OmarAbundis/Habbetat-Colmena-saludable/Control_Sensores_Temp_Hum_CO2_Interior/Base_de_datos_My_SQL_interior_colmena/README.md

# Creación de la base de datos MySQL para los datos del interior de la colmena

# Resumen

La base de datos se creó en una máquina virtual de Ubuntu 20.04 usando MySQL. Los datos obtenidos de los sensores MQ135 y DHT11 son enviados por MQTT en formato json al broker local donde son leìdos por el flow de NodeRed y guardados en nuestra base de datos local usando el nodo MySQL. Posteriormente está base de datos es usada com fuente de datos para un panel de Grafana donde visualizamos el comportamiento local.

# Software a utilizar
* Maquina virtual con Ubuntu 20.04
* My Sql para Linux [Paquete descargable](https://dev.mysql.com/downloads/mysql/)

# Instrucciones para creación de base de datos

1. Abrir una terminal e instalar mysql server con los comandos
* `sudo apt update`
* `sudo apt install mysql-server`
    
2. Ejecutar mysql
* `sudo mysql`
    
3. Crear una nueva base de datos para guardar los datos de los sensores
* `CREATE DATABASE sensor_MQ_DHT;`
    
4. Seleccionar base de datos
* `use sensor_MQ_DHT;`
    
5. Crear una tabla llamada Datos_Sensores que contenga todos los campos necesarios
* `CREATE TABLE Datos_Sensores (n_registro INT(7) UNSIGNED AUTO_INCREMENT PRIMARY KEY, fecha TIMESTAMP DEFAULT CURRENT_TIMESTAMP, id_sensor CHAR (248) NOT NULL, ValorAnalogico FLOAT(7,3) NOT NULL, VoltajeAnalogico FLOAT(7,3) NOT NULL, Temperatura FLOAT(7,3) NOT NULL, Humedad FLOAT(7,3) NOT NULL);`
    
Esto creará la base de datos que guardará nuestros datos que son
* id_sensor
* ValorAnalogico
* VoltajeAnalogico
* Temperatura
* Humedad

6. Se requiere crear un usuario y contraseña para poder ingresar posteriormente desde Grafana a nuestra base de datos, lo creamos usando las instrucciones

* `CREATE USER 'raymundo_soto'@'localhost' IDENTIFIED BY 'contrasena';`
* `GRANT ALL PRIVILEGES ON *.* TO 'raymundo_soto'@'localhost';`

Esto nos permitirá el acceso  a nuestra base de datos local.

7. Para guardar desde Node se usan los siguientes Nodos mqtt, función y MySQL
<p align="center">
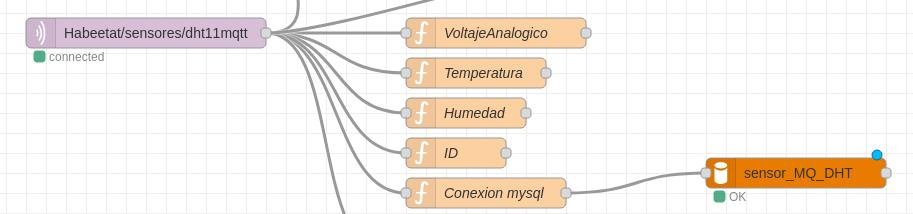
[picture p63: Control_Sensores_Temp_Hum_CO2_Interior/imagenes_interior/raymundo_flow_base_datos_23.jpg]

</p>
* El nodo mqtt se conecta al tópico `Habettat/sensores/dht11mqtt` del broker local donde publica el ESP32
* El nodo función *Conexión mysql* se programa para que publique los datos en la base de datos creada anteriormente, el código del nodo es:

~~~~
msg.topic = "INSERT INTO Datos_Sensores (id_sensor, ValorAnalogico, VoltajeAnalogico, Temperatura, Humedad) VALUES ('" + msg.payload.id + "',
" + msg.payload.ValorAnalogico + "," + msg.payload.VoltajeAnalogico + "," + msg.payload.Temperatura + "," + msg.payload.Humedad +");"
return msg;
~~~~
Este nodo estará enviando los datos a la tabla Datos_Sensores para guardarlos en la base de datos. 

* El nodo mysql ´sensor_MQ_DHT´ se configura para conectarse la base creada en el punto 3; la database debe ser _sensor_MQ_DHT_, el Host localhost, en el puerto 3306 y el usuario y contraseña del punto 6.

<p align="center">

</p>

Una vez creada la base de datos podemos usarla para visualizar datos en Grafana o tomarlos para hacer predicciones de comportamiento.
  
# Resultados

La base de datos con la tabla creada se muestra a continuación

<p align="center">
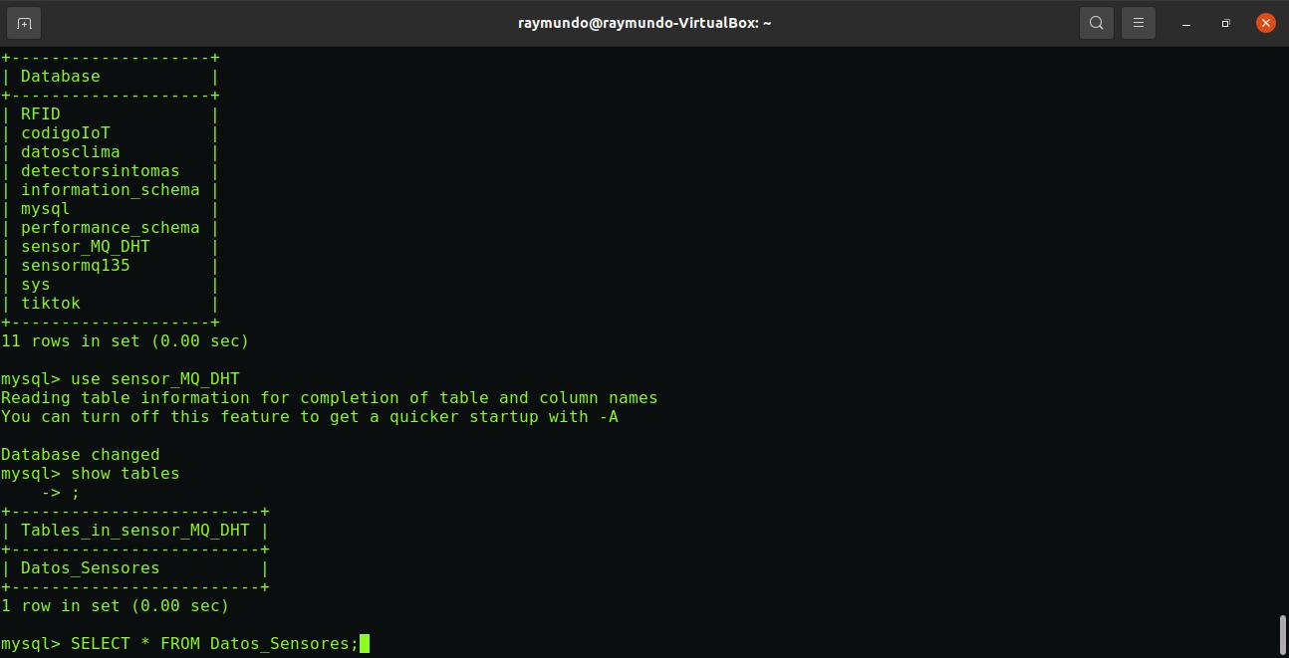
[picture p64: Control_Sensores_Temp_Hum_CO2_Interior/imagenes_interior/raymundo_21_tablas_BD_21.jpg]

</p>

Los datos guardados desde el flow de nodered se muestra en esta imagen
<p align="center">
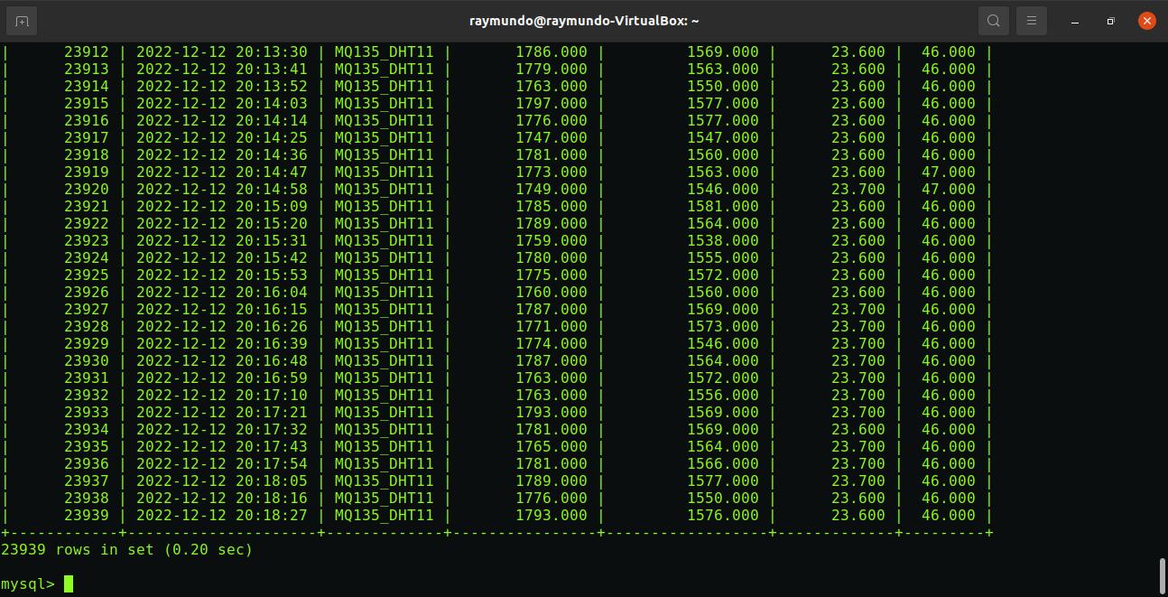
[picture p65: Control_Sensores_Temp_Hum_CO2_Interior/imagenes_interior/raymundo_base_de_datos_datos_22.jpg]

</p>

# Evidencia
Videos de YouTube

1. Funcionamiento de los sensores con MQTT, Nodered y la base de datos MySQL.

https://www.youtube.com/watch?v=seBQrWVgVqA

2. Funcionamiento del bot de Telegram

https://www.youtube.com/watch?v=s4fPHFBnQRI 

3. Panel de Grafana y Dashboard de Nodered

https://youtu.be/pgujhDJBkKk

## Créditos

Este proyecto se realizó gracias al apoyo de los profesores

- Lizbeth García León [Github](https://github.com/lizgarcialeon)
- Hugo Escalpelo [Github](https://github.com/hugoescalpelo/detector-sintomas-covid)
- Omar Abundis Noyola [Github](https://github.com/OmarAbundis)
- Raymundo Soto Soto [Github](https://github.com/raymundosoto)
