OmarAbundis/Habbetat-Colmena-saludable/Control_Sensores_Temp_Hum_CO2_Interior/imagenes_interior/README.md

## Carpeta con las imágenes de los sensores interiores, cámara y predición del peso.
