OmarAbundis/Habbetat-Colmena-saludable/Control_Sensores_Temp_Hum_CO2_Interior/Flow_Nodered_monitoreo_interior_colmena/README.md

## Creación del flow en Nodered para suscribirse, leer los datos enviados a tópicos en el broker local, guardarlos en la base de datos local y controlar el envío de mensajes con los datos de la colmena a telegram mediante un bot.
