OmarAbundis/Habbetat-Colmena-saludable/Site_Web_Creacion/Imagenes/HABEETAT.pptx

## HABEETAT: COLMENA SALUDABLE

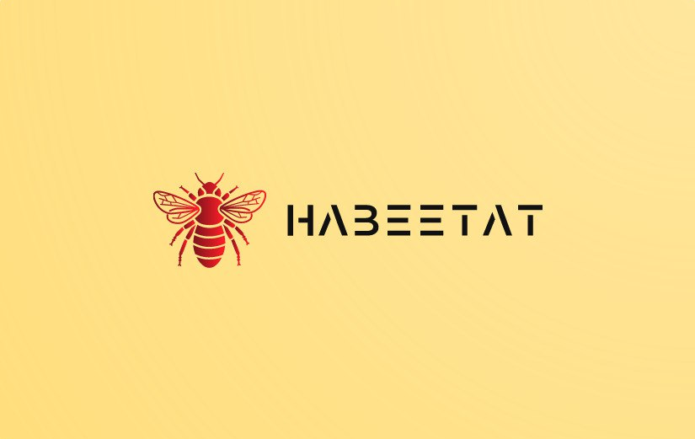
[picture p138: figure]

- Integrantes del equipo:
- Abundis Noyola Omar
- García León Lizbeth
- Soto Soto Raymundo

## JUSTIFICACIÓN:

- Buscar una solución mediante el uso del Internet de las cosas, que garantice la salud de la colmena.
- Monitorear las principales variables que nos alertaran que la salud de la colmena está en franco peligro.
- Llevar un registro de los valores detectados mediante la implementación de una base de datos en MySQL.
- Mandar señales a actuadores para que se pongan en funcionamiento o en caso de emergencia se detone una llamada de alerta a la persona propietaria o encargada de la colmena.
- Simplificar la observación de los datos mediante gráficas en tiempo real haciendo uso de Grafana
- Utilizar algoritmos de predicción para diagnostico de condiciones.

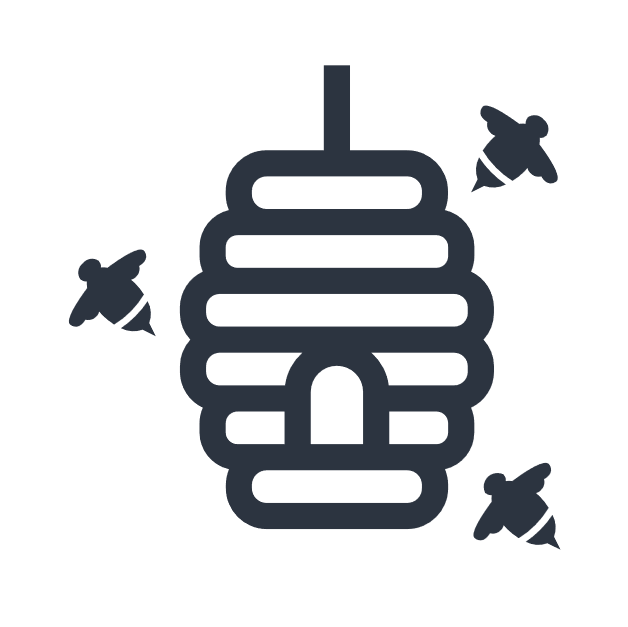
[picture p139: figure]

## OBJETIVO GENERAL:

Diseñar un prototipo de monitoreo que permita registrar, en tiempo real, las principales variables que garantizan la salud de una colmena de abejas melíferas, bajo el paradigma del Internet de las cosas; y con ello, mejorar las prácticas de la apicultura, propiciar una explotación sustentable y cuidado del ambiente en diversas regiones de México.

## Implementación de sensores

A027

## Programación de servicios

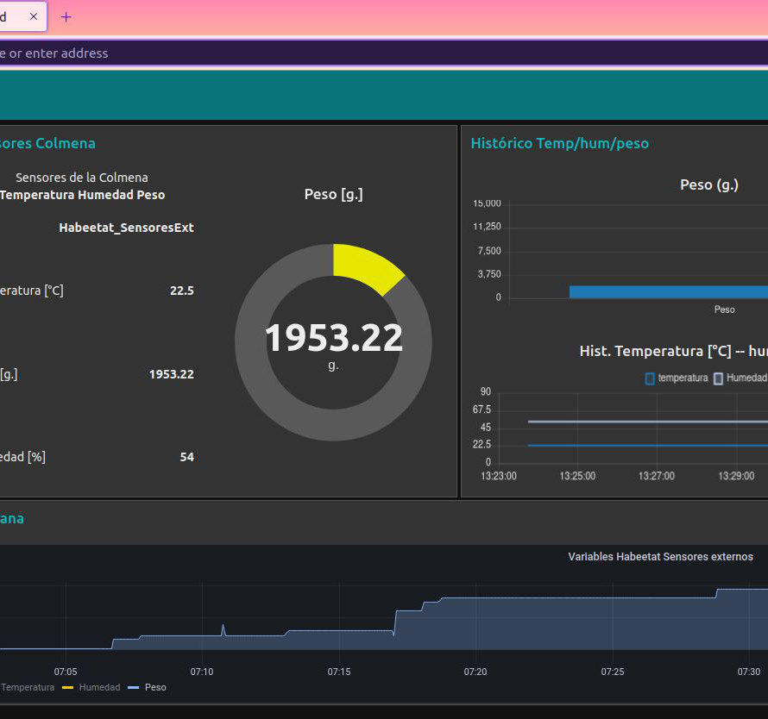
[picture p140: figure]
A048
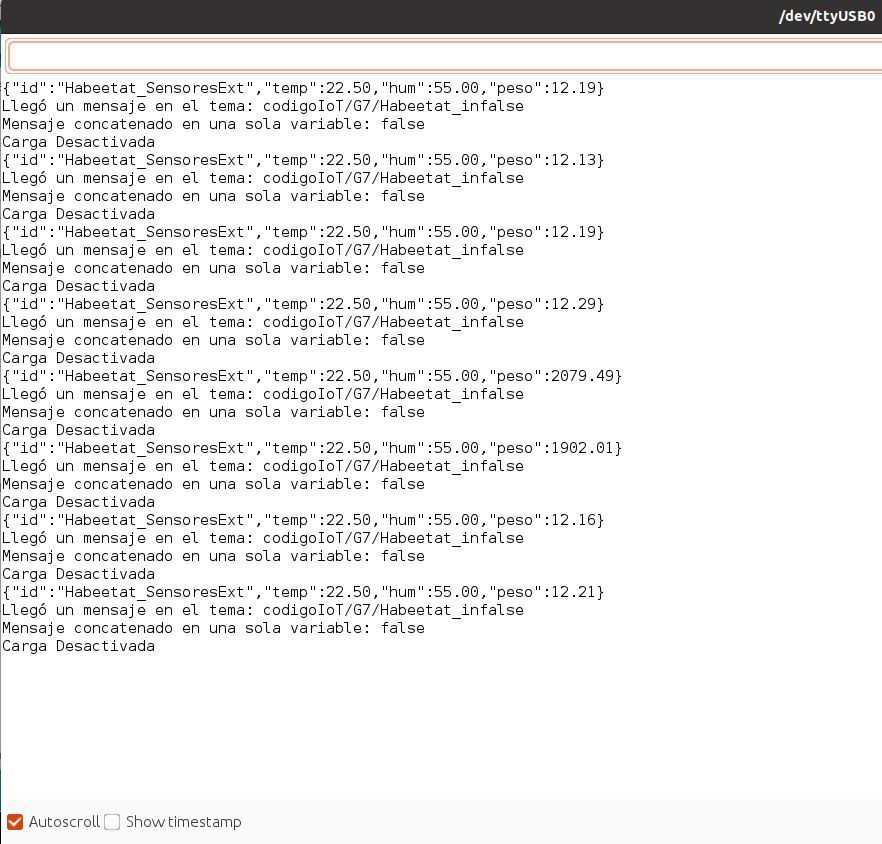
[picture p141: figure]
A035
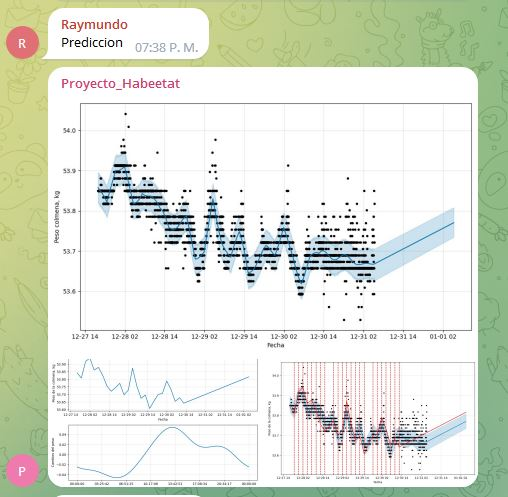
[picture p142: figure]
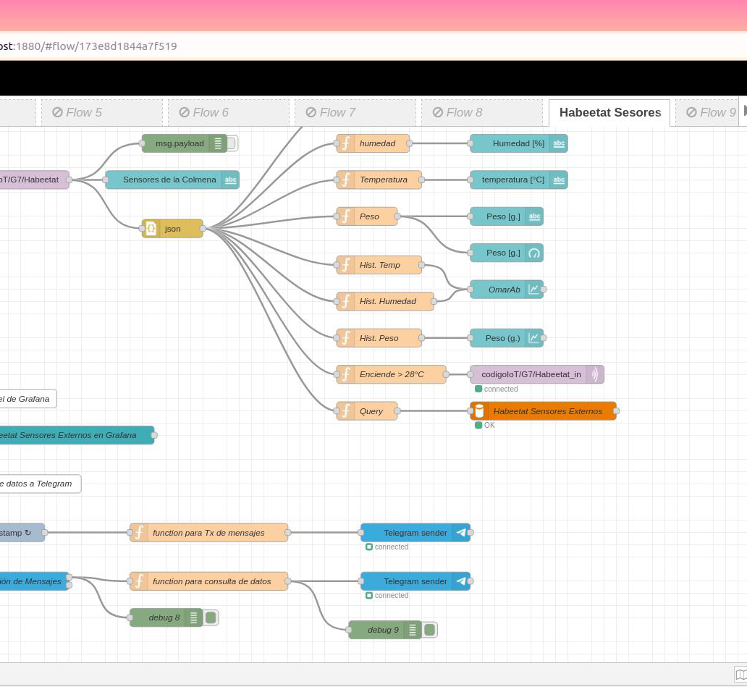
[picture p143: figure]
A045
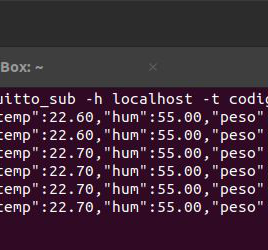
[picture p144: figure]
A037

## Escalado, cooperación y aplicación

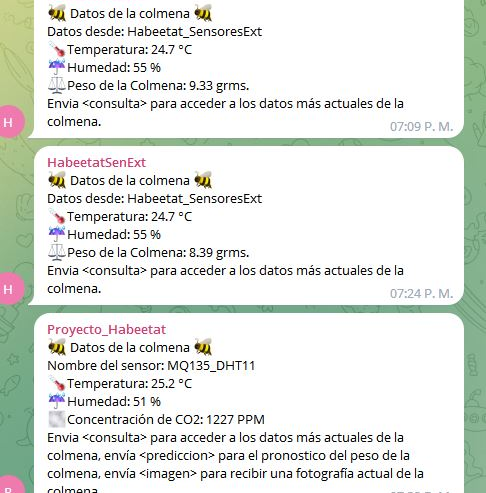
[picture p145: figure]
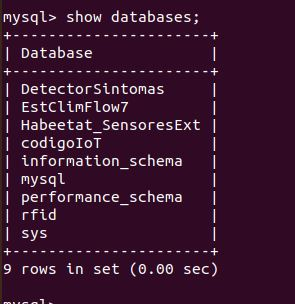
[picture p146: figure]
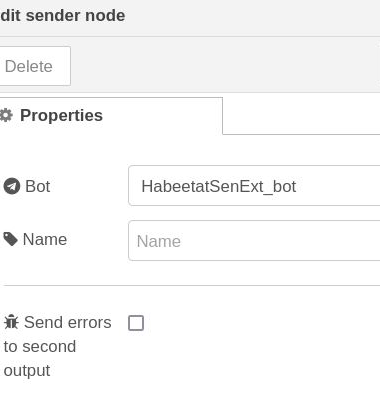
[picture p147: figure]

## conclusiones:

## referencias

- Taylor, S. J., & Letham, B. (2018). Forecasting at scale. The American Statistician, 72(1), 37-45.
