OmarAbundis/Habbetat-Colmena-saludable/Site_Web_Creacion/Site3/files/1.Introduccin.pdf

# Introducción

Las abejas son importantes en los ecosistemas debido a su papel como polinizadoras de plantas. Según un estudio realizado por la Universidad de Harvard (Goulson, 2013), las abejas polinizan más del 70% de las especies vegetales cultivadas en todo el mundo, lo que las convierte en una especie clave en la producción de alimentos. Además, las abejas también contribuyen a la conservación de la biodiversidad al polinizar plantas silvestres y ayudar a mantener la salud de los ecosistemas naturales.

Para cuidar la salud de las abejas, es importante mantener su colonia libre de enfermedades y plagas. Esto se puede lograr mediante varias medidas, tales como:

- Proporcionar una fuente de alimento adecuada y consistente para las abejas, que incluya tanto polen como néctar.
- Colocar la colmena en un lugar seguro y protegido de los elementos, y alejado de fuentes de contaminación.
- Evitar el uso de productos químicos cerca de la colmena, ya que pueden ser perjudiciales para las abejas.
- Realizar inspecciones regulares de la colmena para detectar cualquier signo de enfermedad o indicio de plaga.
- Cambiar periódicamente a la reina para mantener una producción constante de abejas en la colmena.
- Trabajar con otros apicultores locales para compartir información y conocimientos sobre la salud de las abejas.

Además de estas medidas, es importante estar al tanto de las últimas investigaciones y desarrollos en el campo de la apicultura, para poder implementar las prácticas más recientes y eficaces para mantener la salud de las abejas.

Existen más factores que se deben considerar para mantener una colmena saludables. La temperatura, humedad y concentración de dióxido de carbono en una colmena tienen un gran impacto en la salud de la misma. Por ejemplo: Una temperatura adecuada en la colmena es esencial para el desarrollo saludable de las abejas y la producción de miel. La humedad también es importante, ya que las abejas utilizan la humedad para regular la temperatura en la colmena y ayudar a solidificar la miel. Una concentración adecuada de dióxido de carbono en la colmena también es esencial, ya que las abejas utilizan el dióxido de carbono para producir la cera que se utiliza en la construcción de las celdas de miel. En general, mantener un equilibrio adecuado de temperatura, humedad y dióxido de carbono en la colmena puede ayudar a garantizar la salud y el bienestar de las abejas.

Los valores ideales de temperatura y humedad dentro de una colmena varían en función de la época del año y el tipo de abejas que habitan en ella. En general, la temperatura óptima para las abejas dentro de la colmena suele estar entre los 35 y los 38 grados Celsius. La humedad ideal suele estar entre el 40% y el 60%.

La cantidad de dióxido de carbono en una colmena puede variar, pero en general se considera que un nivel adecuado de CO2 dentro de una colmena debe estar entre 0.1 y 0.2 % (100 a 200 partes por millón). Esta cantidad de CO2 es suficiente para mantener a las abejas saludables y ayudar a prevenir enfermedades como el síndrome de muerte de las colmenas. Sin embargo, es importante tener en cuenta que un nivel de CO2 demasiado alto puede resultar perjudicial para las abejas y puede provocar su muerte. Por lo tanto, es importante asegurarse de que el nivel de CO2 dentro de la colmena sea el adecuado.

Desarrollo y explotación sustentable de las colmenas de abejas

La explotación y desarrollo sustentable de las colmenas implica considerar tanto la salud y bienestar de las abejas como la de las personas que las manejan y de los ecosistemas en los que se encuentran. Algunas formas de lograr una explotación y desarrollo sustentable de las colmenas incluyen:

1. Adoptar prácticas de manejo responsable: Esto incluye proporcionar a las abejas una dieta adecuada, evitar el uso de productos químicos tóxicos en las colmenas y en el entorno, y asegurar que las colmenas estén en buenas condiciones para que las abejas puedan vivir y trabajar cómodamente.
2. Utilizar técnicas de apicultura sostenible: Esto puede incluir la utilización de técnicas de producción de miel más sostenibles, como la apicultura sin cría, que evita la producción de miel en exceso y reduce el estrés en las abejas.
3. Colaborar con otros apicultores: Trabajar en conjunto con otros apicultores puede ayudar a promover la sostenibilidad a través de la colaboración y el intercambio de conocimientos y experiencias.
4. Promover la conservación de los ecosistemas: Las colmenas son una parte importante de muchos ecosistemas, y su conservación es esencial para el bienestar de las abejas y el medio ambiente en general. Esto puede incluir la promoción de la conservación de hábitats naturales y la restauración de áreas degradadas.
5. Fomentar la educación y conciencia: A través de la educación y la concientización, se puede promover una mayor comprensión y apreciación de la importancia de las abejas y de cómo podemos contribuir a su conservación y bienestar.

El internet de las cosas para el desarrollo sustentable de las colmenas

El Internet de las Cosas (IoT, por sus siglas en inglés) puede ser utilizado para el desarrollo sustentable de las colmenas de varias maneras. Algunas posibles opciones son:

1. Monitoreo de la salud de las colmenas: se pueden utilizar sensores IoT para monitorear la temperatura, humedad y otros parámetros clave de las colmenas, lo que permite identificar problemas de salud temprano y tomar medidas para evitar la pérdida de colmenas.
2. Control de plagas: se pueden utilizar sensores IoT para detectar plagas como las varroas, lo que permite a los apicultores tomar medidas para controlar la plaga de manera oportuna y evitar daños a las colmenas.
3. Gestión de la producción de miel: se pueden utilizar dispositivos IoT para monitorear la producción de miel y optimizar los procesos de recolección y procesamiento para maximizar la eficiencia y reducir el impacto ambiental.
4. Mejora de la movilidad: se pueden utilizar dispositivos IoT para mejorar la movilidad de las colmenas, por ejemplo, a través de la automatización del proceso de traslado de las colmenas a diferentes ubicaciones para optimizar la cosecha de néctar.

En general, el uso del IoT en la apicultura puede ayudar a mejorar la eficiencia, reducir el impacto ambiental y mejorar la sostenibilidad de la actividad apícola.

Uso ético del Internet de las cosas para monitorear abejas

1. El uso ético del Internet de las Cosas (IoT) para monitorear abejas incluye la consideración de la privacidad y seguridad de los apicultores. Es importante garantizar que los datos recogidos por los dispositivos IoT no se compartan con terceros sin el consentimiento de los apicultores y que se adopten medidas de seguridad adecuadas para proteger los datos de posibles ataques cibernéticos.

2. Otro aspecto ético a considerar es el impacto ambiental de los dispositivos IoT. Es importante utilizar dispositivos de bajo consumo de energía y reciclables para minimizar el impacto ambiental y promover la sostenibilidad.
3. Además, es importante asegurarse de que el uso del IoT para monitorear abejas no interrumpa o altere el comportamiento natural de las abejas de manera negativa. Los dispositivos deben ser diseñados de manera que no cause estrés o daño a las abejas.
4. Es también importante asegurarse de que el uso del IoT para monitorear abejas no esté en desacuerdo con las leyes o regulaciones aplicables. Por ejemplo, en algunos lugares puede estar prohibido el uso de ciertos dispositivos o tecnologías para monitorear abejas.
5. Por último, es importante promover la transparencia y la comunicación clara en cuanto al uso del IoT para monitorear abejas. Los apicultores deben ser informados de cómo se utilizan los dispositivos y cómo se recogen y utilizan los datos, y deben tener la oportunidad de optar por no participar si así lo desean.

De acuerdo al portal del proyecto europeo IoBee (https://io-bee.eu/) , el cual está encargado de combatir la mortalidad de la abejas a través del monitoreo inteligente y ayudarlas a enfrentar los desafíos ambientales que se presentan actualmente, la importancia de la abejas se puede medir en términos económicos de la siguiente forma: “The most important contribution bees make to agriculture is the pollination service they provide. The direct value of honey produced in the EU is estimated at €140 million, while the value of insect pollination for European agriculture has been estimated to be approximately €20 billion per year, and €153 billion worldwide.” Por lo que resulta vital a corto y mediano plazo diseñar planes que las ayuden a sobrevivir y sobre todo que sean amigables para el ambiente y rentables económicamente.

Referencias

1. Goulson, D. (2013). An Introduction to the Biology of Bees. Oxford University Press.
2. IoBee. (s/f). Io-Bee.Eu. Recuperado el 17 de diciembre de 2022, de https://io-bee.eu/
