OmarAbundis/Habbetat-Colmena-saludable/Control_Sensores_Temp_Hum_CO2_Interior/imagenes_interior/raymundo_base_de_datos_DHT11MQ135_14.jpg

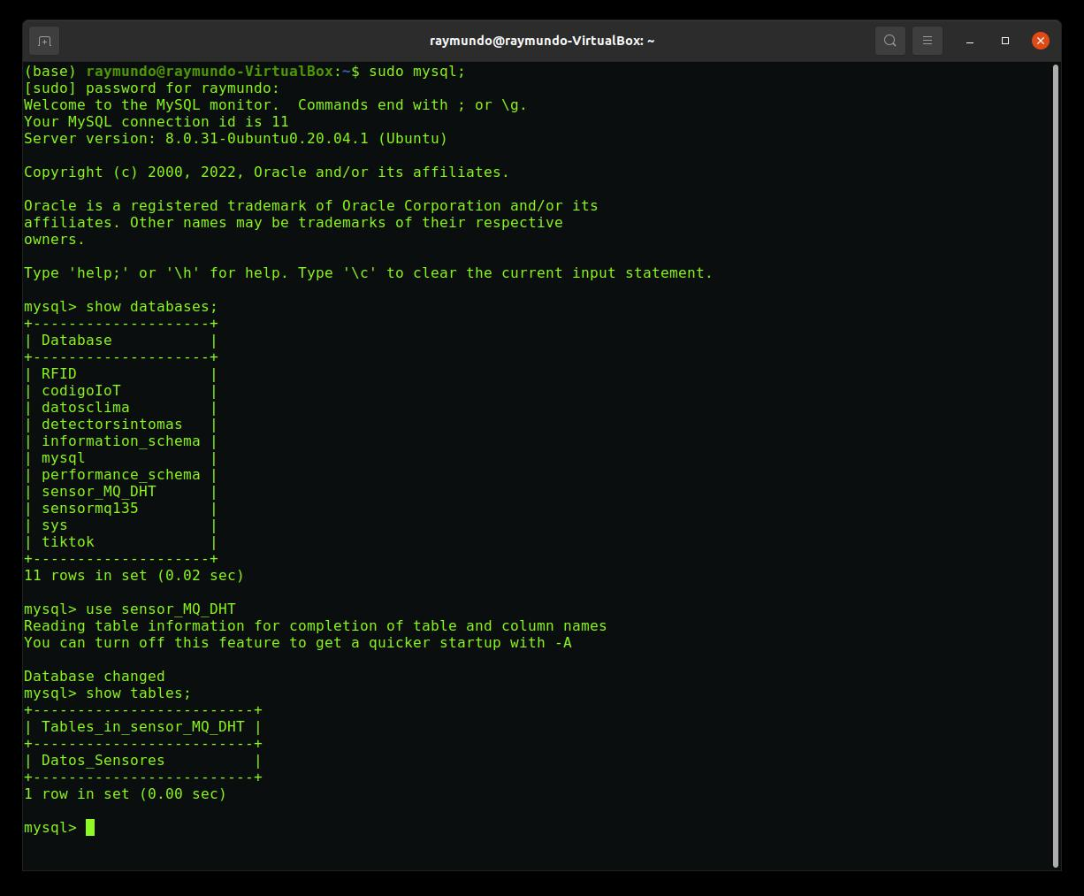
Control_Sensores_Temp_Hum_CO2_Interior/imagenes_interior/raymundo_base_de_datos_DHT11MQ135_14.jpg
