OmarAbundis/Habbetat-Colmena-saludable/Control_Sensores_Temp_Hum_CO2_Interior/imagenes_interior/raymundo_consulta_colmena_05.jpg

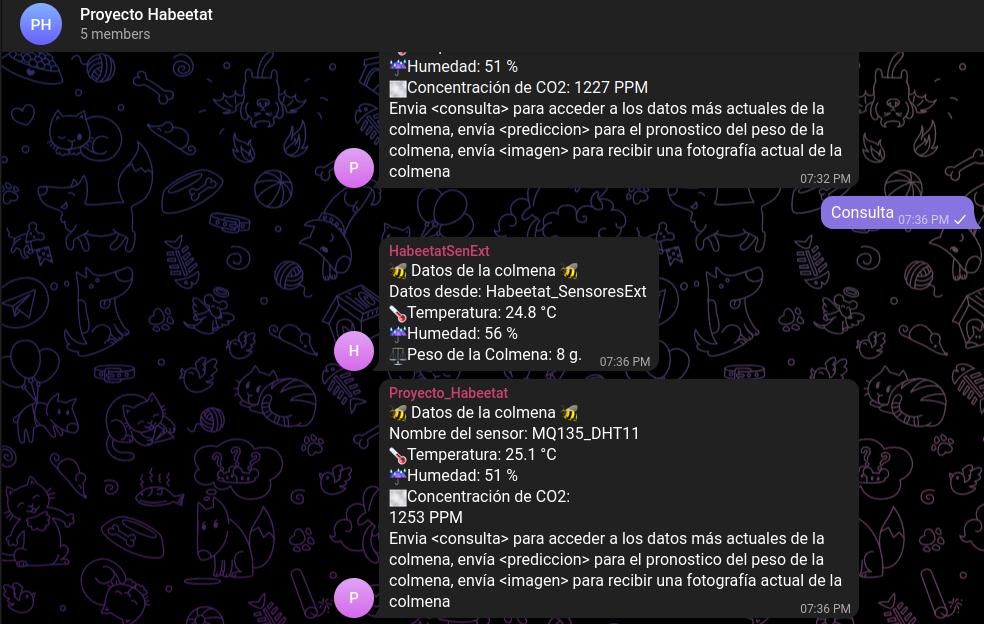
Control_Sensores_Temp_Hum_CO2_Interior/imagenes_interior/raymundo_consulta_colmena_05.jpg
