OmarAbundis/Habbetat-Colmena-saludable/Control_Sensores_Temp_Hum_CO2_Interior/imagenes_interior/raymundo_consulta_datos_010.png

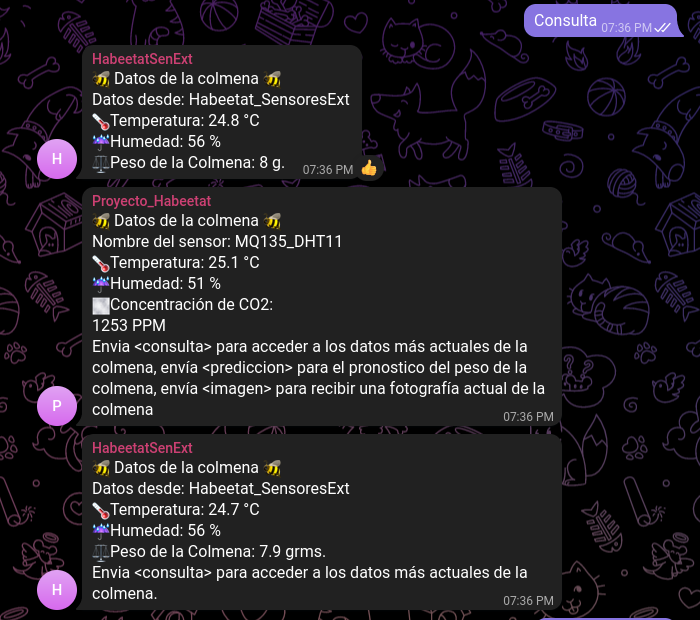
Control_Sensores_Temp_Hum_CO2_Interior/imagenes_interior/raymundo_consulta_datos_010.png
