OmarAbundis/Habbetat-Colmena-saludable/Control_Sensores_Temp_Hum_CO2_Interior/imagenes_interior/raymundo_cron_archivo_11.jpg

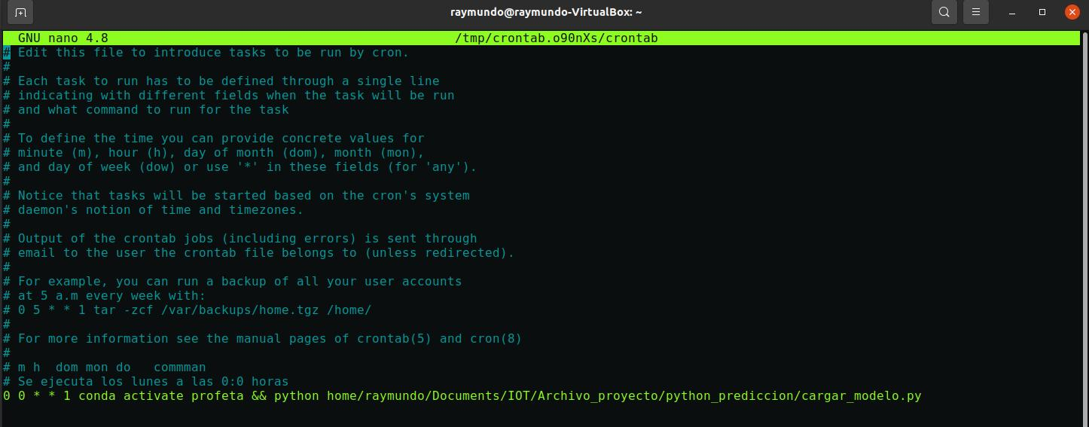
Control_Sensores_Temp_Hum_CO2_Interior/imagenes_interior/raymundo_cron_archivo_11.jpg
