OmarAbundis/Habbetat-Colmena-saludable/Site_Web_Creacion/Imagenes/blog.jpg

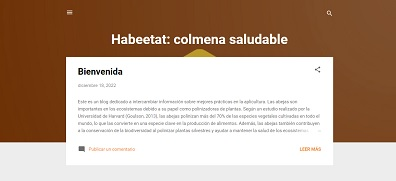
Site_Web_Creacion/Imagenes/blog.jpg
