OmarAbundis/Habbetat-Colmena-saludable/Site_Web_Creacion/Imagenes/colmenao.jpg

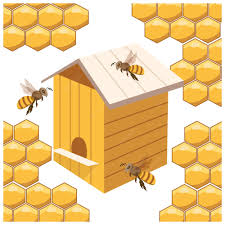
Site_Web_Creacion/Imagenes/colmenao.jpg
