OmarAbundis/Habbetat-Colmena-saludable/Site_Web_Creacion/Imagenes/colmenat.jpg

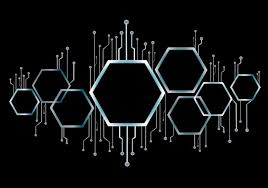
Site_Web_Creacion/Imagenes/colmenat.jpg
