OmarAbundis/Habbetat-Colmena-saludable/Site_Web_Creacion/Imagenes/colmenath.png

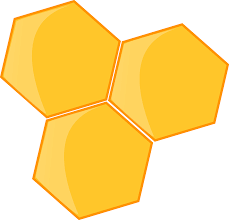
Site_Web_Creacion/Imagenes/colmenath.png
