OmarAbundis/Habbetat-Colmena-saludable/Site_Web_Creacion/Imagenes/colmeproy.jpg

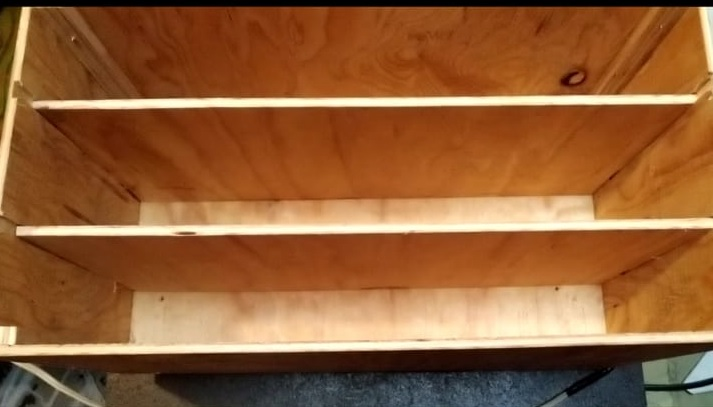
Site_Web_Creacion/Imagenes/colmeproy.jpg
