OmarAbundis/Habbetat-Colmena-saludable/Site_Web_Creacion/Imagenes/conexion hx711.jpg

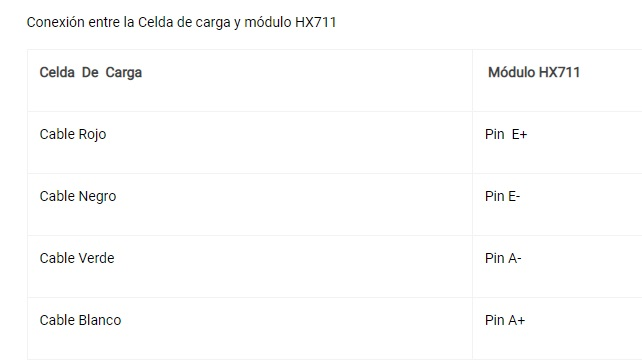
Site_Web_Creacion/Imagenes/conexion hx711.jpg
