OmarAbundis/Habbetat-Colmena-saludable/Site_Web_Creacion/Imagenes/conexion wroom.png

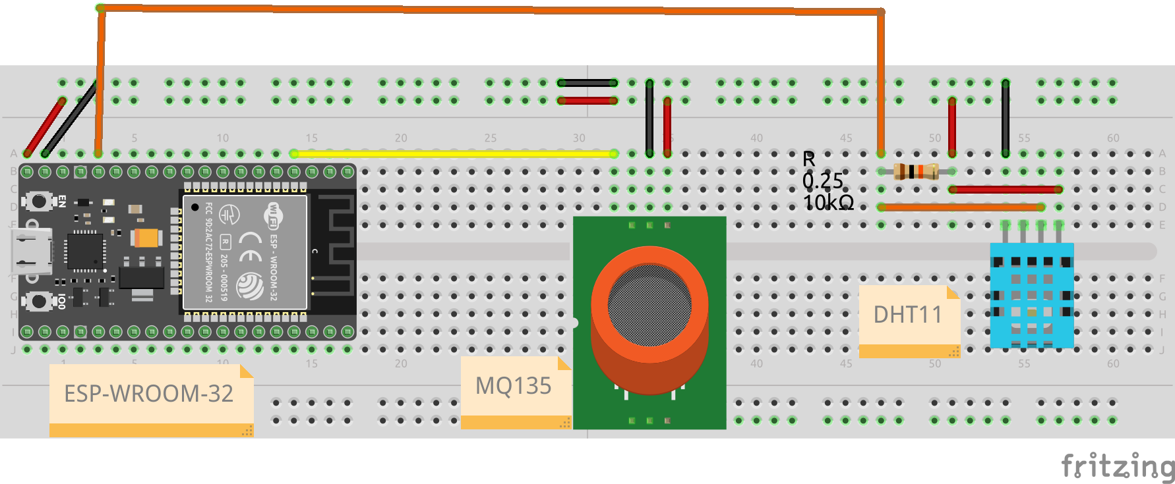
Site_Web_Creacion/Imagenes/conexion wroom.png
