OmarAbundis/Habbetat-Colmena-saludable/Site_Web_Creacion/Imagenes/conexionesp32cam.jpg

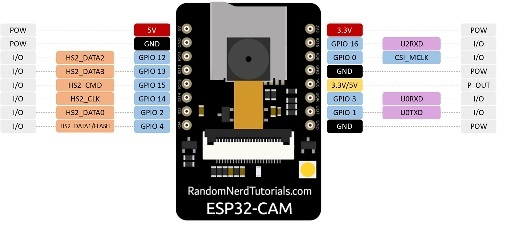
Site_Web_Creacion/Imagenes/conexionesp32cam.jpg
