OmarAbundis/Habbetat-Colmena-saludable/Site_Web_Creacion/Imagenes/direccion paginaweb.png

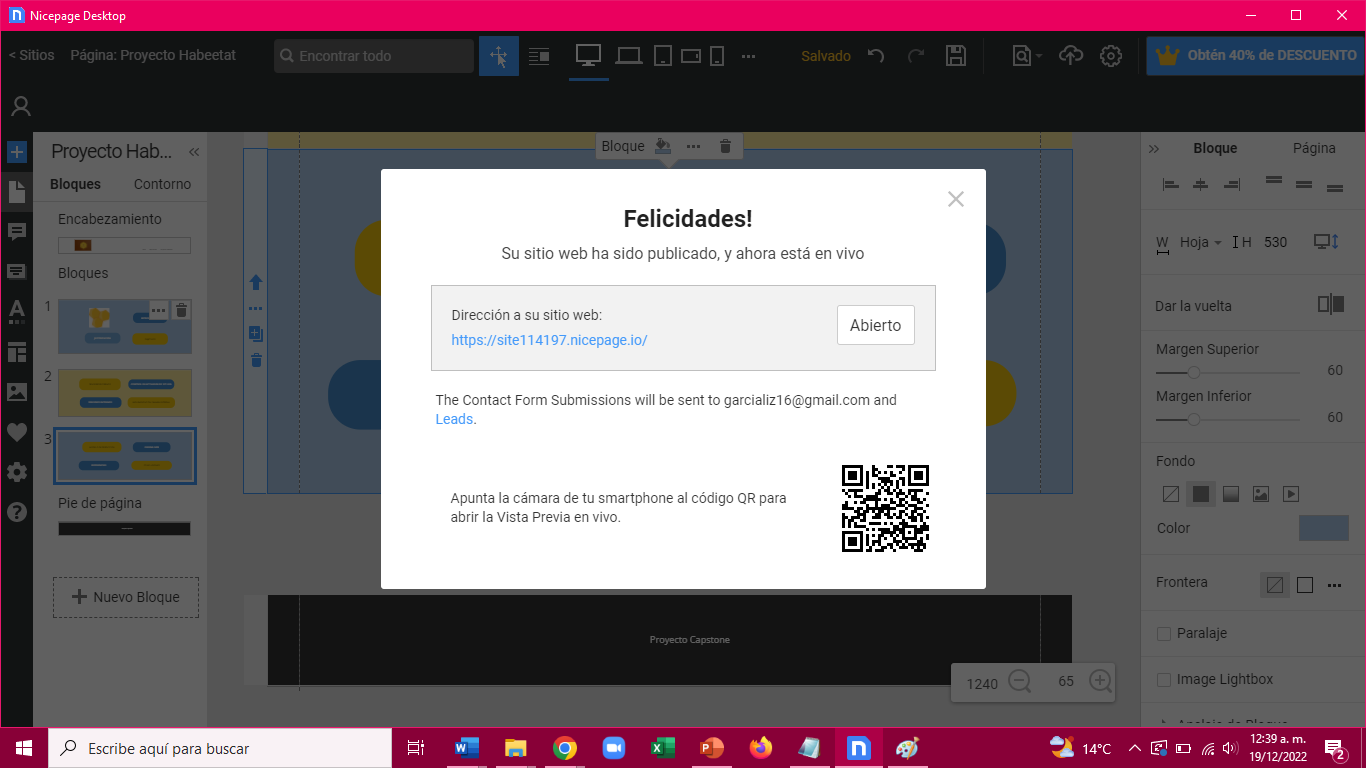
Site_Web_Creacion/Imagenes/direccion paginaweb.png
