OmarAbundis/Habbetat-Colmena-saludable/Site_Web_Creacion/Imagenes/esp32cam.jpg

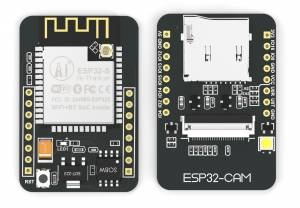
Site_Web_Creacion/Imagenes/esp32cam.jpg
