OmarAbundis/Habbetat-Colmena-saludable/Site_Web_Creacion/Imagenes/espwroom.png

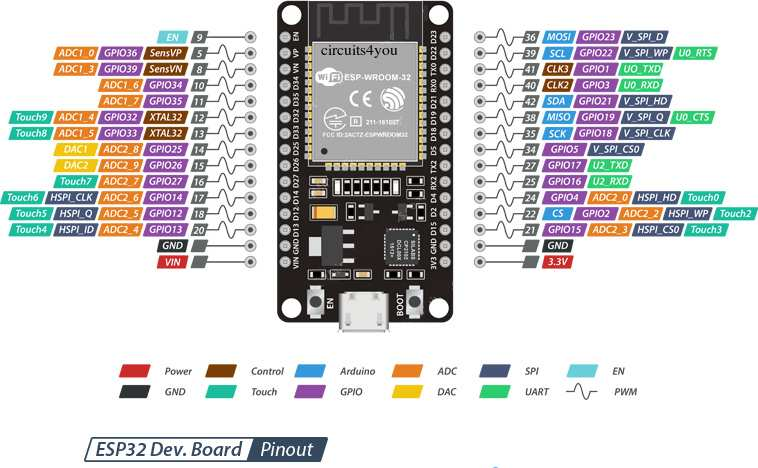
Site_Web_Creacion/Imagenes/espwroom.png
