OmarAbundis/Habbetat-Colmena-saludable/Site_Web_Creacion/Imagenes/esquematico.jpg

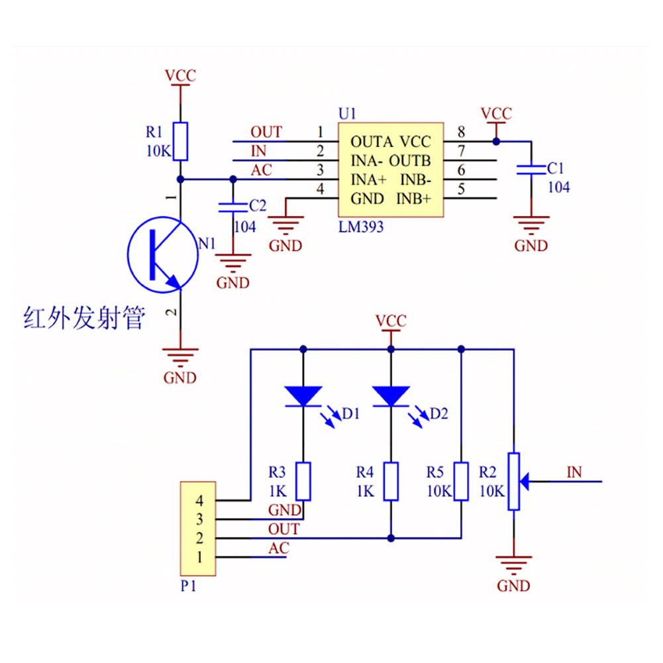
Site_Web_Creacion/Imagenes/esquematico.jpg
