OmarAbundis/Habbetat-Colmena-saludable/Site_Web_Creacion/Imagenes/hb.jpeg

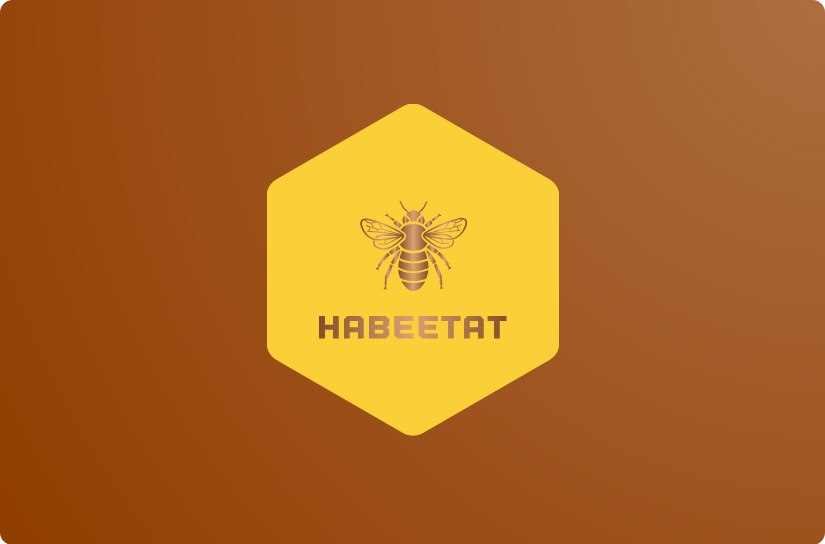
Site_Web_Creacion/Imagenes/hb.jpeg
