OmarAbundis/Habbetat-Colmena-saludable/Site_Web_Creacion/Imagenes/hx711.png

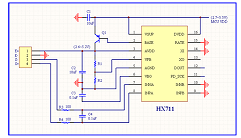
Site_Web_Creacion/Imagenes/hx711.png
