OmarAbundis/Habbetat-Colmena-saludable/Site_Web_Creacion/Imagenes/mq135.jpg

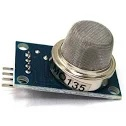
Site_Web_Creacion/Imagenes/mq135.jpg
