OmarAbundis/Habbetat-Colmena-saludable/Site_Web_Creacion/Imagenes/ph.png

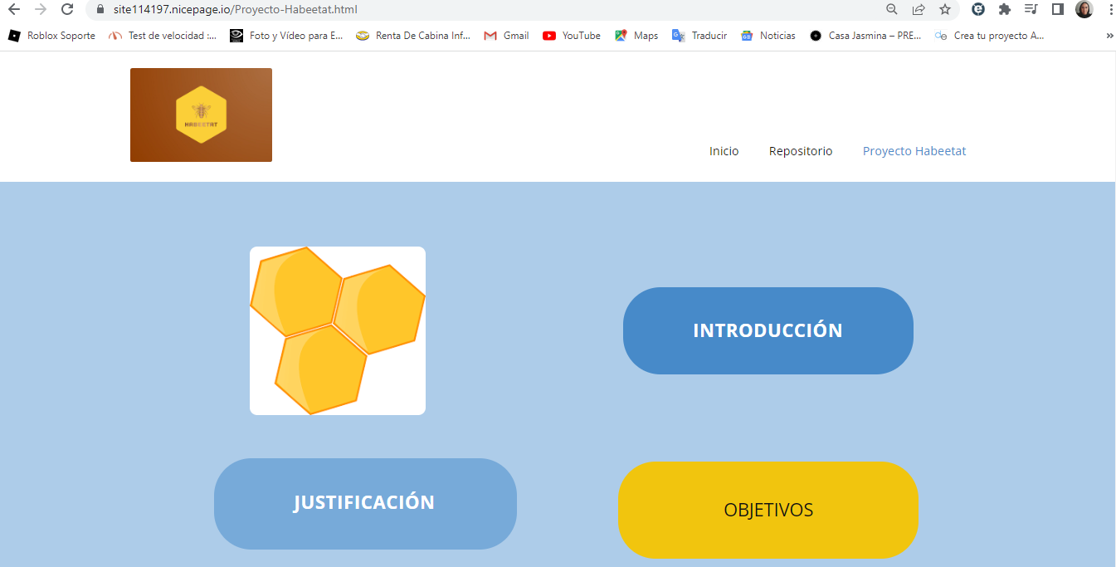
Site_Web_Creacion/Imagenes/ph.png
