OmarAbundis/Habbetat-Colmena-saludable/Site_Web_Creacion/Imagenes/predicmenudos.jpg

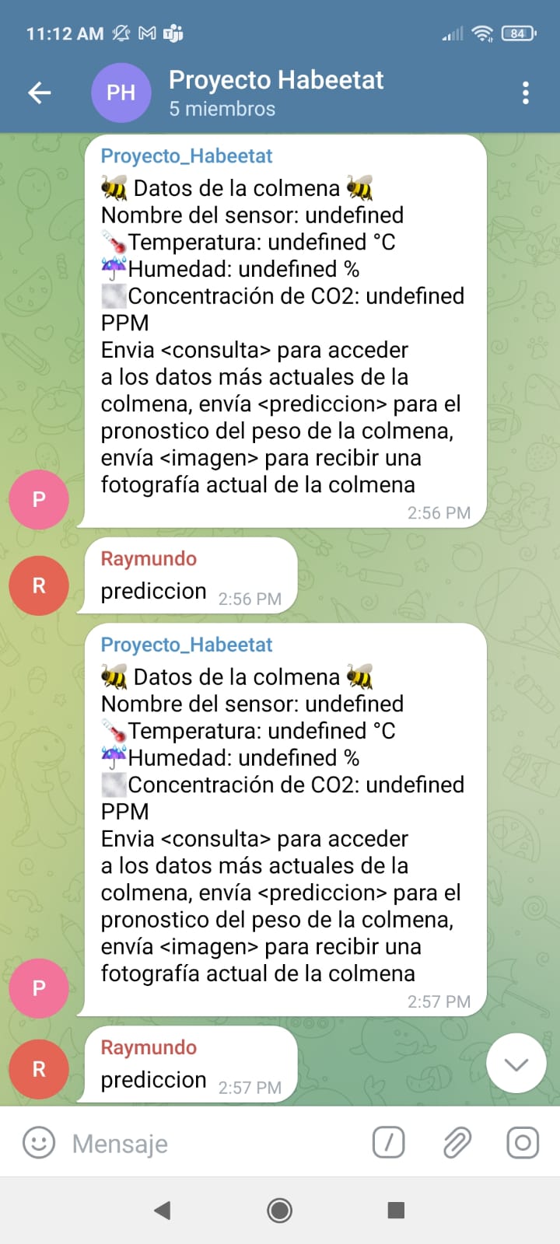
Site_Web_Creacion/Imagenes/predicmenudos.jpg
