OmarAbundis/Habbetat-Colmena-saludable/Site_Web_Creacion/Imagenes/predictres.jpg

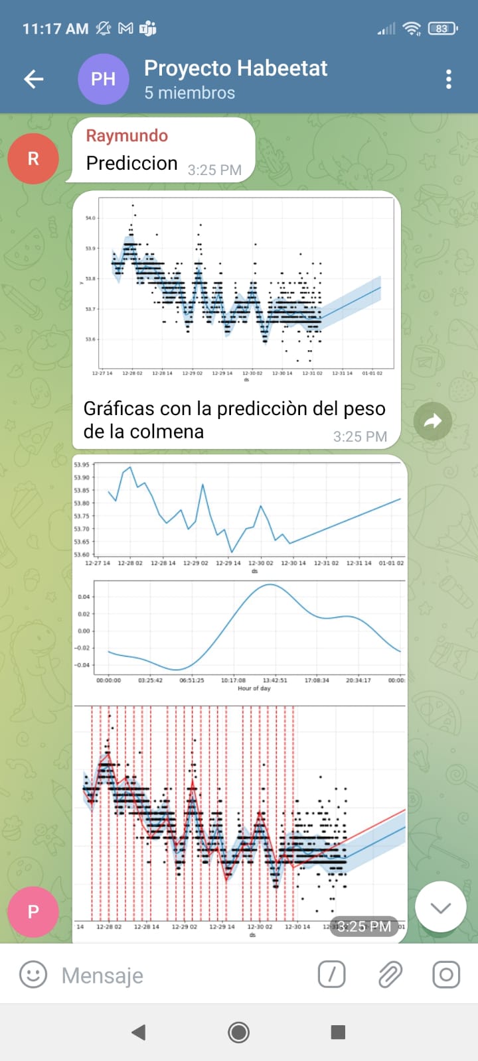
Site_Web_Creacion/Imagenes/predictres.jpg
