OmarAbundis/Habbetat-Colmena-saludable/Site_Web_Creacion/Imagenes/programa.jpg

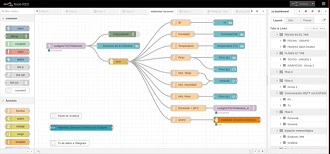
Site_Web_Creacion/Imagenes/programa.jpg
