OmarAbundis/Habbetat-Colmena-saludable/Site_Web_Creacion/Imagenes/qrcodigoiot.jpg

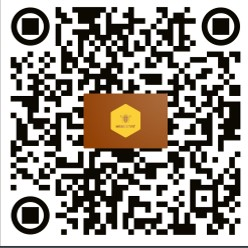
Site_Web_Creacion/Imagenes/qrcodigoiot.jpg
