OmarAbundis/Habbetat-Colmena-saludable/Site_Web_Creacion/Imagenes/qrgithub.jpg

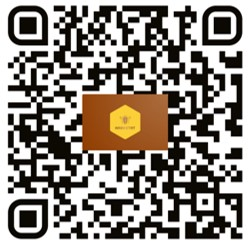
Site_Web_Creacion/Imagenes/qrgithub.jpg
