OmarAbundis/Habbetat-Colmena-saludable/Site_Web_Creacion/Imagenes/sensordt11.jpg

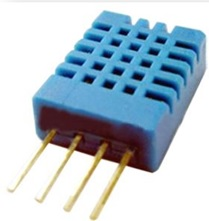
Site_Web_Creacion/Imagenes/sensordt11.jpg
