OmarAbundis/Habbetat-Colmena-saludable/Site_Web_Creacion/Imagenes/sensorhumedad.jpg

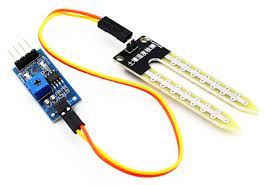
Site_Web_Creacion/Imagenes/sensorhumedad.jpg
