OmarAbundis/Habbetat-Colmena-saludable/Site_Web_Creacion/Imagenes/sensorpeso.jpg

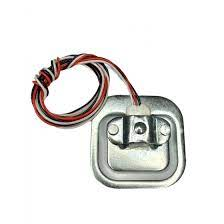
Site_Web_Creacion/Imagenes/sensorpeso.jpg
