OmarAbundis/Habbetat-Colmena-saludable/Site_Web_Creacion/Imagenes/sensortemp.jpg

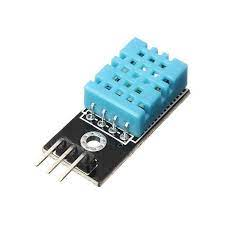
Site_Web_Creacion/Imagenes/sensortemp.jpg
