OmarAbundis/Habbetat-Colmena-saludable/Site_Web_Creacion/Imagenes/telegram.png

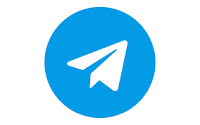
Site_Web_Creacion/Imagenes/telegram.png
