OmarAbundis/Habbetat-Colmena-saludable/Site_Web_Creacion/Imagenes/telegrammenu.jpeg

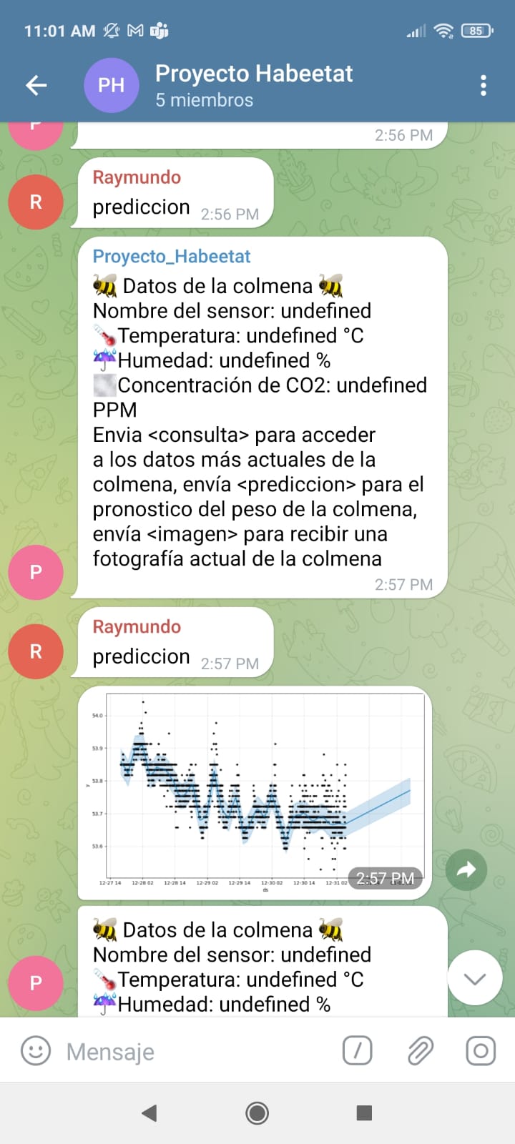
Site_Web_Creacion/Imagenes/telegrammenu.jpeg
