OmarAbundis/Habbetat-Colmena-saludable/(commit log)

2022-10-04 HabeetatSensores y Ajuste tara
    Flow en NodeRed
    Corrección de tara ante fallas eléctricas.
    HabeetatSensores
2022-10-18 Reajuste con la colmena nueva
2022-10-18 Creación de la carpeta
2022-10-18 Creación del archivo Readme
    Se crea el archivo readme
2022-10-18 Se edita el material a utilizar
2022-10-18 Se agrega material
2022-10-18 Se modifica el readme
    Se
2022-10-19 cambio de nombre
2022-10-19 Cambio de líneas
2022-10-21 Activación de carga y cambio de ID
2022-11-21 Creación de carpetas
2022-11-21 Descripción de prophet
2022-11-21 Creación de los README
2022-11-21 Se añade el código para usar la cámara
    Este código sirve para conectar el ESP32 CAM al wifi y tener en servicio el servidor web para captura de imagen y vídeo
2022-11-21 Cambio de autores
2022-11-21 Se agregó el cñodigo con los resultados
    Se agreó el código con los resultados de la predicciòn del peso de la colmena
2022-11-21 Se modifica el archivo .py
2022-11-21 Archivo de texto con todas las bibliotecas usandas
    No hay cambios
2022-11-21 Archivo json con el modelo
2022-11-21 Se agregan las imagenes con la predicción
2022-11-21 Se agrega el archivo CSV con los datos del peso de la colmena
2022-11-22 Código para sensores del interior de la colmena
    Se crea el archivo .ino con el código para leer sensores en el interior de la colmena
2022-11-22 Update Sensor_DHT11_MQ135_WiFI_MQTT.ino
    Actualizaciòn del programa
2022-11-22 Se generan los readme de las carpetas
2022-11-28 Actualizaciones de los readme
2022-11-29 Cambio de imagen
2022-11-30 Subir imagen consulta de datos
2022-11-30 Se modifica el orden
2022-12-04 Se agrega imagen y actualiza el readme
2022-12-04 Imágenes base de datos
2022-12-04 Nuevo nombre de archivos
2022-12-04 Se cambia el nombre
2022-12-04 Actualización de imáganes y readme
2022-12-05 Se actualiza el código
    Se incluyó la función de calibraciópn del sensor
2022-12-05 Se actualiza la función de calibración del sensor
2022-12-05 Actualización de la función de calibración
2022-12-13 Se añade el json de grafana
